projectswithalex/Reaction-Lights-Training-Module/BuildParts/Pictures/Picture3_1.jpg

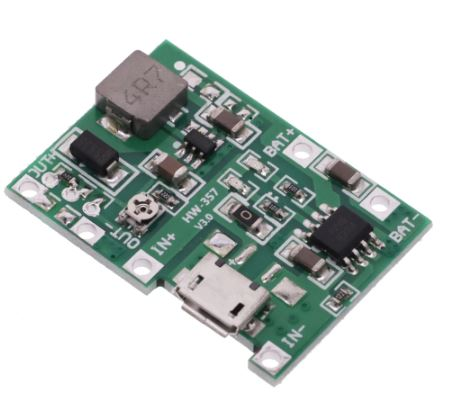
BuildParts/Pictures/Picture3_1.jpg
