projectswithalex/Reaction-Lights-Training-Module/BuildParts/Pictures/Picture3_2.jpg

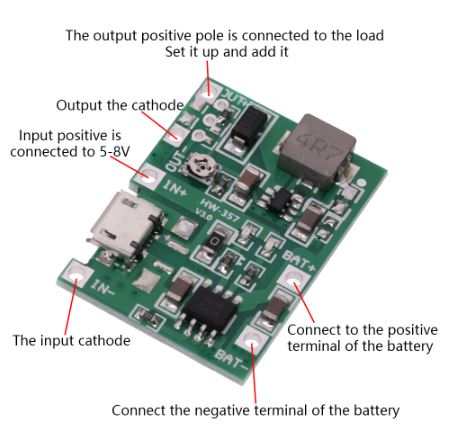
BuildParts/Pictures/Picture3_2.jpg
