projectswithalex/Reaction-Lights-Training-Module/BuildParts/Connection Representation/AgilityLights_Master.png

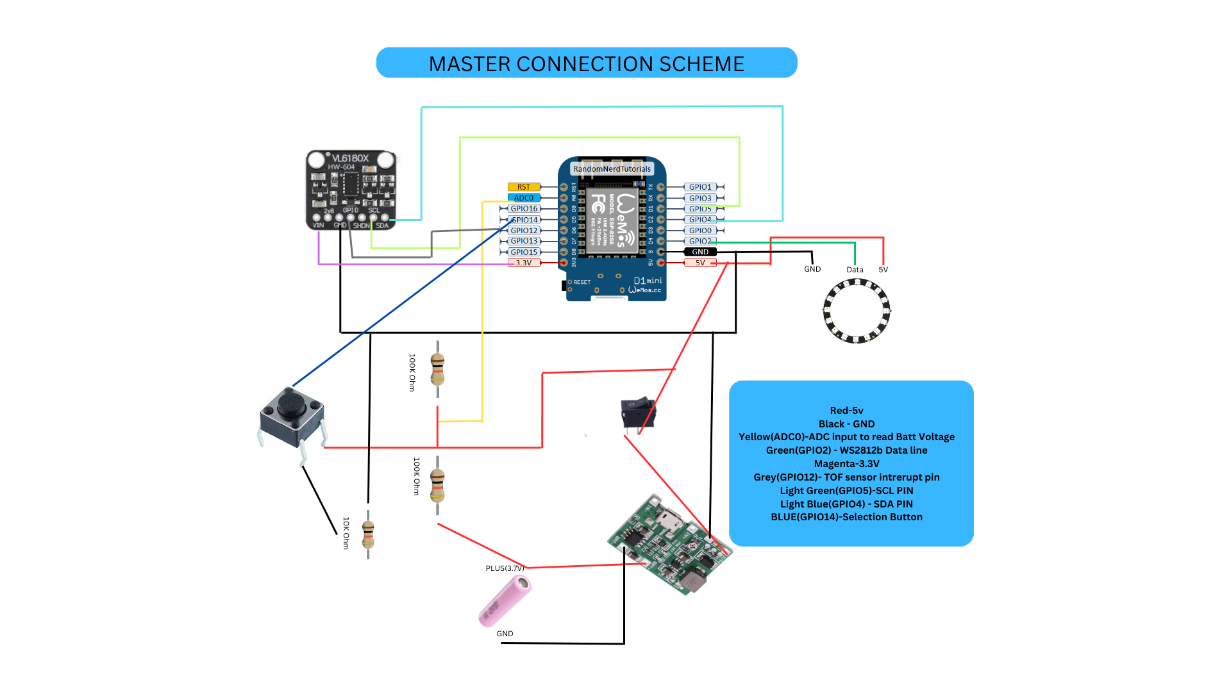
BuildParts/Connection Representation/AgilityLights_Master.png
