projectswithalex/Reaction-Lights-Training-Module/BuildParts/Connection Representation/AgilityLights_NotMaster.png

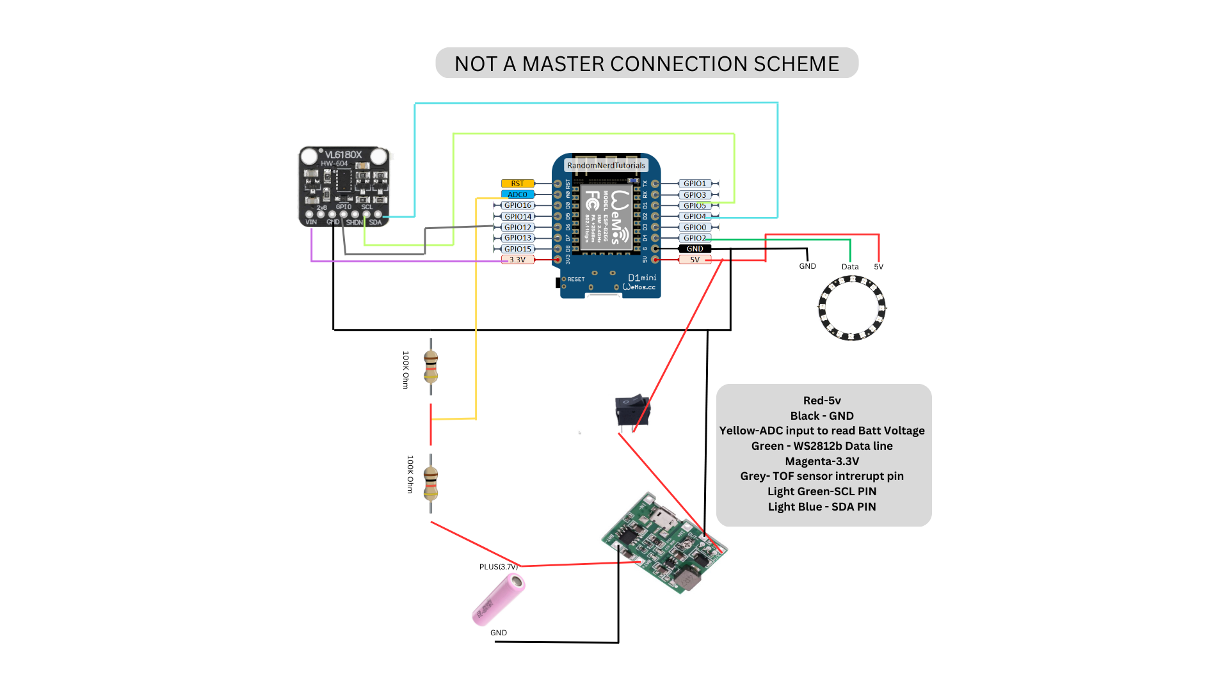
BuildParts/Connection Representation/AgilityLights_NotMaster.png
