projectswithalex/Reaction-Lights-Training-Module/BuildParts/Pictures/Picture1.jpg

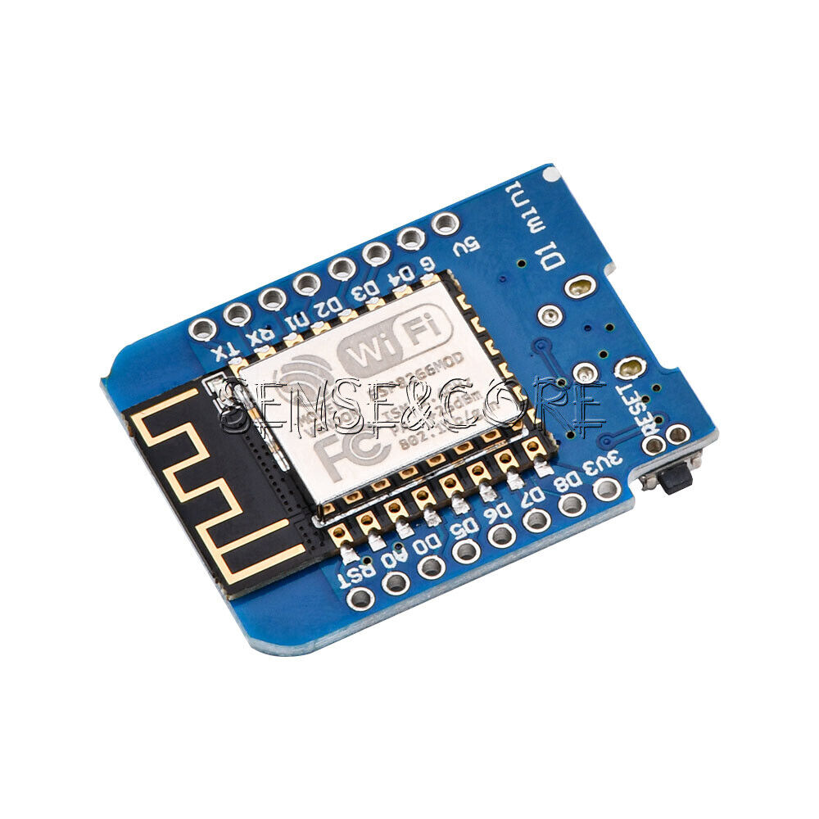
BuildParts/Pictures/Picture1.jpg
