projectswithalex/Reaction-Lights-Training-Module/BuildParts/Pictures/Picture1_2.jpg

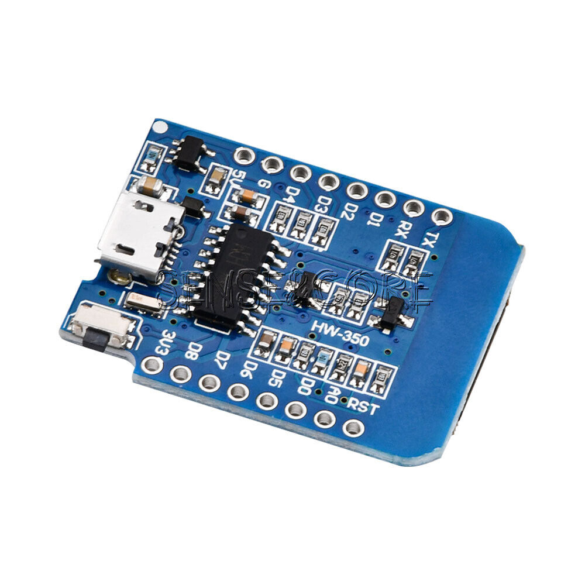
BuildParts/Pictures/Picture1_2.jpg
