projectswithalex/Reaction-Lights-Training-Module/BuildParts/Pictures/Picture2.jpg

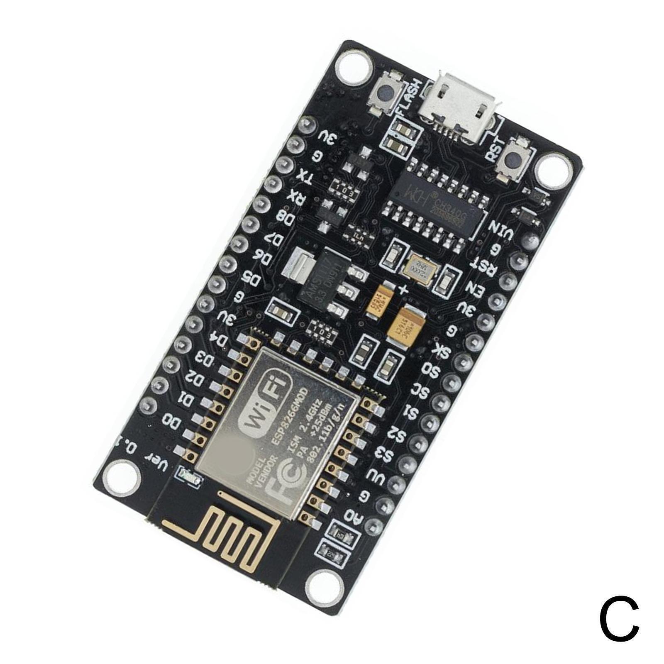
BuildParts/Pictures/Picture2.jpg
