projectswithalex/Reaction-Lights-Training-Module/BuildParts/Pictures/Picture4.jpg

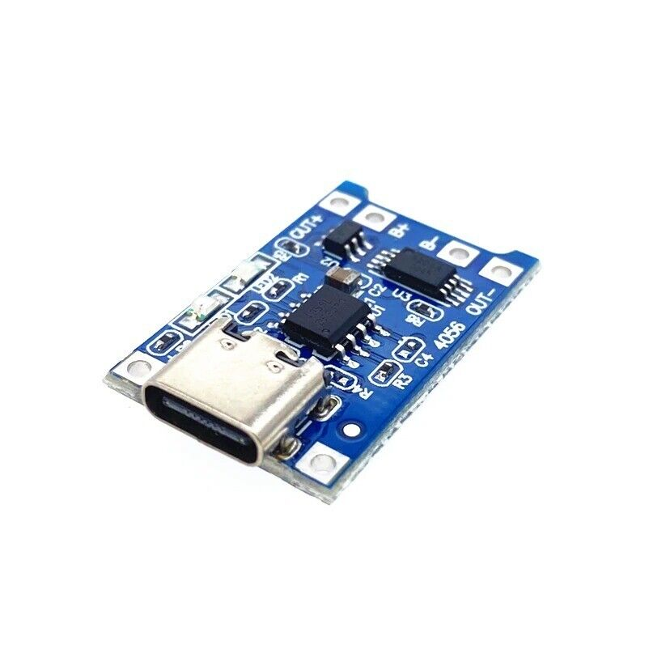
BuildParts/Pictures/Picture4.jpg
