projectswithalex/Reaction-Lights-Training-Module/BuildParts/Pictures/Picture5_1.jpg

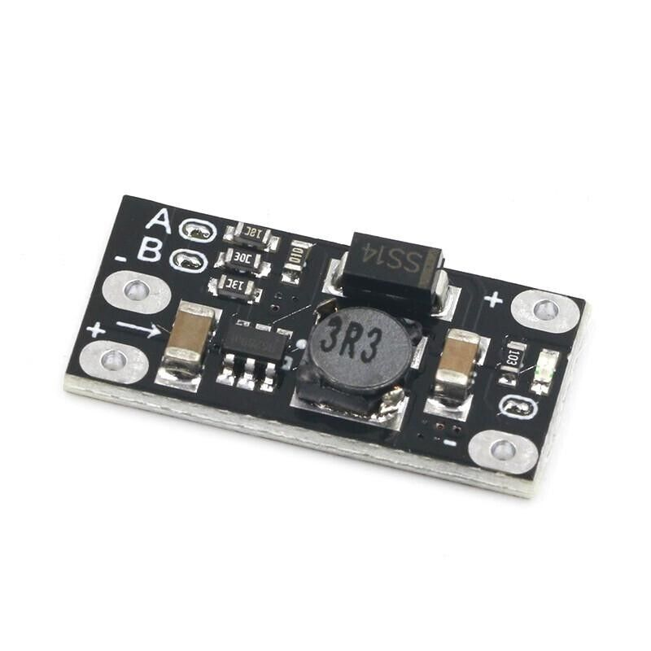
BuildParts/Pictures/Picture5_1.jpg
