projectswithalex/Reaction-Lights-Training-Module/BuildParts/Pictures/Picture5_2.jpg

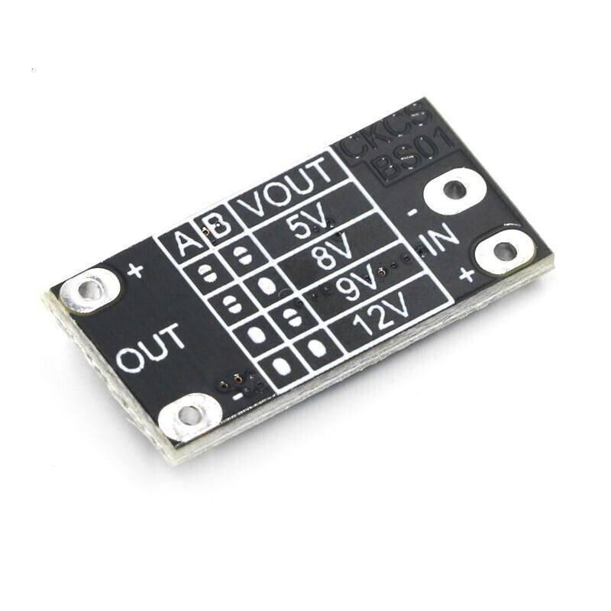
BuildParts/Pictures/Picture5_2.jpg
