projectswithalex/Reaction-Lights-Training-Module/BuildParts/Pictures/Picture6.jpg

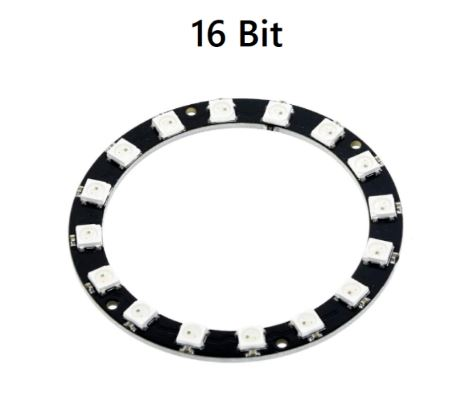
BuildParts/Pictures/Picture6.jpg
