projectswithalex/Reaction-Lights-Training-Module/BuildParts/Pictures/Picture7.jpg

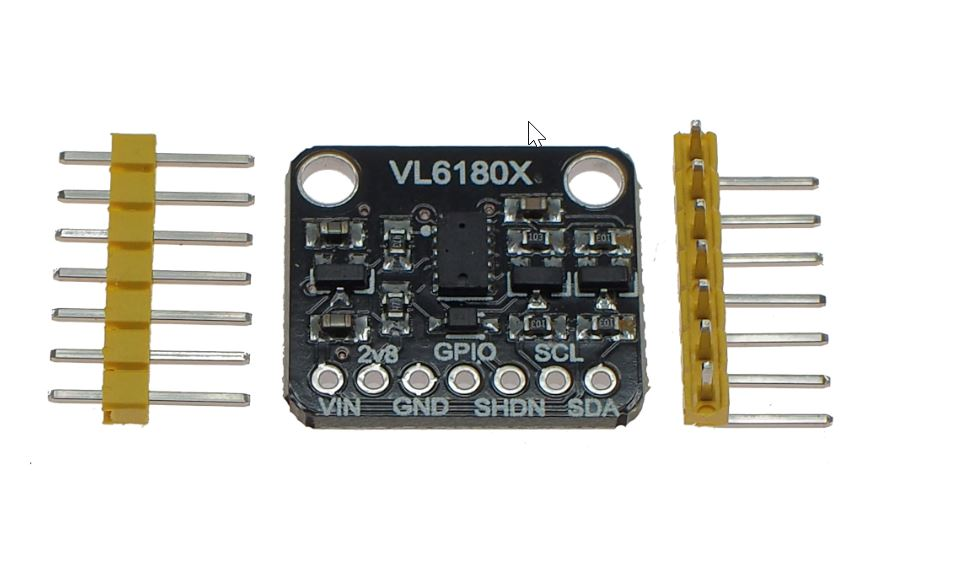
BuildParts/Pictures/Picture7.jpg
