projectswithalex/Reaction-Lights-Training-Module/BuildParts/Pictures/Picture8.jpg

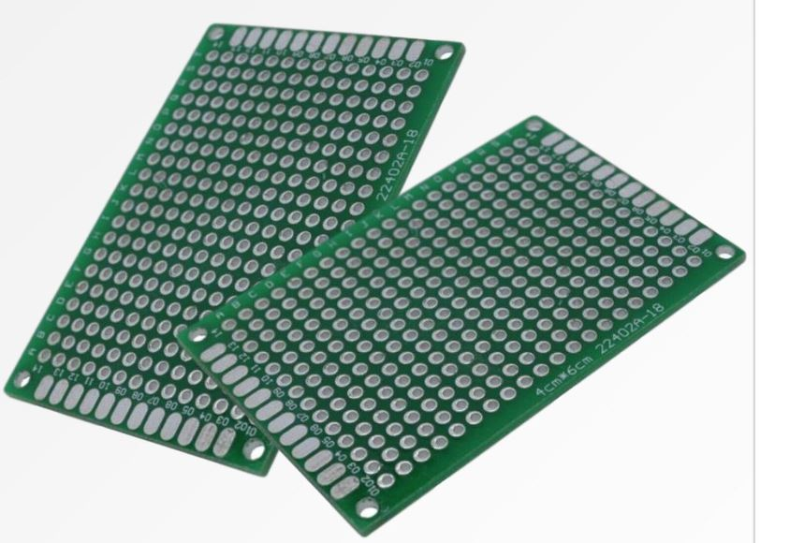
BuildParts/Pictures/Picture8.jpg
