projectswithalex/Reaction-Lights-Training-Module/BuildParts/Pictures/Picture9.jpg

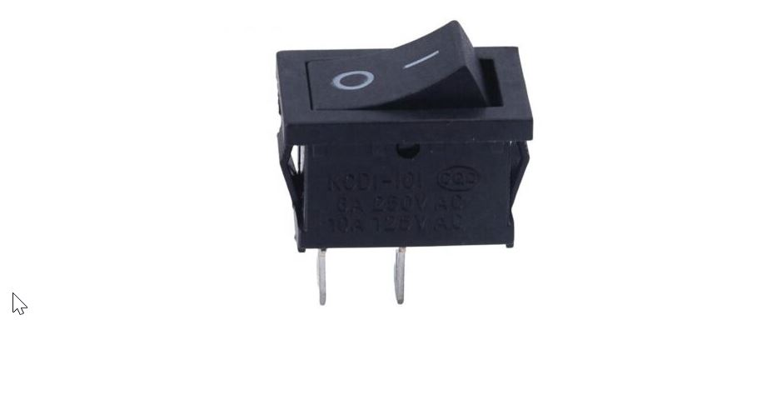
BuildParts/Pictures/Picture9.jpg
