projectswithalex/Reaction-Lights-Training-Module/(threads)

Thread 1 (2023-09-22):

wiring

gemyo1, 2023-09-22:
hello,
thanks for this project.
can you make a document with the wiring on the differents electronics cards please
I want to make my own reaction light but I'm a noob with this cards.

thank you very much

TheprofessionalKhaled, 2023-09-28:
you are right ...the wiring is missing with the appropiate values resisters in the power circuit ..and the proper connection of the sensor

gemyo1, 2023-09-28:
Thanks for the answer, i look forward for the wiring.
;-)

Le jeu. 28 sept. 2023 à 12:15, TheprofessionalKhaled <
***@***.***> a écrit :

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

TheprofessionalKhaled, 2023-09-28:
I already message alex directly on his mail asking him for the wiring ....I
hope he reply to it

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

projectswithalex, 2023-09-28:
Updated "Schematic" (Visual Representation) of the connections for Agility Lights.  (commit #38c155d )

gemyo1, 2023-09-29:
Thanks very much,
It will be very helpful !

Le jeu. 28 sept. 2023, 23:36, projectswithalex ***@***.***> a
écrit :

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

TheprofessionalKhaled, 2023-09-29:
thanks man I appreciate that

Closed 2023-09-28.

Thread 2 (2023-12-26):

Sensor Isn't responding ( high probale cause from code )

TheprofessionalKhaled, 2023-12-26:
hi...how are you ....after several months trying to solve the same issue and asking alot in lots of groups ...I have to open the issue here

First I explian the issue I faced in detail while I record the video of my Project which contian the black piece so please see it as I found I could show the case clearly while operating practical on the project
It is an open source project from alex ...

what happens with my project when I push button the transit to the next configuration settings (which is the job of the sensor ) it didn't transit ...or the sendor didn't take the order
I attach a link to drive I uploaded the video which I record the issue to it so see the video https://drive.google.com/file/d/1cyDlgMK7oVrM3J1ZjFgxhj60-C7nzBI_/view?usp=drive_link

After asking alot  they told me mostly it is from the code, functions responsible for sensoror may be you forgot to determine aspecific settings I should adust (replace here comment)

I also note e 2 things when I connect esp directly to the usb port of the pc first when I apply the test (lightanddistance)the sensor responds and the voltage out from esp8266(from 3.3v and G pins) to sensor is 4.6 to 4.8 v but when I upload the main code of the project and remove the test one the voltage out from esp8266(from 3.3v and G pins) to sensor is 5.6 to 5.8 and the voltage out to ws2818 led rgb ring is from 6.7 to 7 volt even it only accepts 5v written on it So what is that means ?
the second thing like I said i connect the esp to the pc and measure this power i only can measure the volt with avo when i put the avo in the state on alternate voltage V~(avo picture that the arrow of callibration to the green ) and cannot read when avo to points to the red part so what is that mean I thought it reads when its directed to the dc volt ?
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
![Uploading received_893958295349191.jpeg…]
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

gemyo1, 2024-01-03:
Hello,
i made myself this project and i have exactly the same problem.

thx

TheprofessionalKhaled, 2024-01-03:
Like I told you mr alex something is wrong

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

simowilso, 2024-12-28:
I think I'm getting the same/similar problem - did anyone manage to solve this?
In the serial output I can see:
initTOFSensor
initBatteryCheck
battery perc75
almost Ready
Ready
modeSelect:1

I get the modeSelect:1 when pressing the button, but nothing from the TOF sensor.
Pressing the button again gives - training_SelectNrOfECUs:1
and then training_nrOfColors:1

@projectswithalex could you offer any assistance please?

simowilso, 2024-12-29:
Not sure if anyone's still here, but I have got this to work. I've forked my own repo for now as I am a bit of a git amateur and don't really know how to get the changes into a PR. (Not sure if Alex would approve the PR anyway)

TheprofessionalKhaled, 2024-12-29:
What changes do you make that makes the project works …i am really curious?

simowilso, 2024-12-29:
I changed all the classes that the Time of Flight sensor uses from the VL6180X library to VL6180X_WE

See here for changes to ECU1.ino https://github.com/simowilso/Reaction-Lights-Training-Module

TheprofessionalKhaled, 2024-12-29:
So do you mean the problem is from code not electrical issues

Are you sure that the project works fine now ?

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

TheprofessionalKhaled, 2024-12-29:
I cannot believe for more than one year maybe year and half
I spent alots of money
i thought it from electrical or logic
As I studied code and at the end
The error was from using different library than needed

Thanks allah at the end
I appreciate learning alot
And simo for your effort to end that cycle so i can go to another project

Best regards

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

simowilso, 2024-12-29:
I have it working with just the master ECU and one other. I plan to make 5 in total but I think it will work yes. Only code changes except the wiring for the push button on the master - it's not clear from the original drawing how that should be.

Sent from Outlook for Android<https://aka.ms/AAb9ysg>
________________________________
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

TheprofessionalKhaled, 2024-12-29:
you can simplify the pushbutton with 4 legs is same like the one with only
2 legs you connect one leg to D5 and gnd ...the other leg to the voltage
pin ................in the representation he connected to 5 volt but after
asking the pins on the esp is not designed to handle 5 volt
so connect the leg to 3.3 volt pin

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

TheprofessionalKhaled, 2024-12-29:
please if any updates in your project please share it

but how you detect the issue is from the library ...are you a
professional that you get it from experience or is there a clue that says
that happens because of wrong library ?

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

simowilso, 2024-12-29:
There was a test program in the repo that also didn't work- one that read out the distance from the sensor. In the _WE library there' was also a test program and this one did print out the distance values. So I knew the hardware was ok. I updated the test program and got that to work. (This code also updated in my fork). I used to be a C programmer about thousand years ago so yeah a bit of experience.

Sent from Outlook for Android<https://aka.ms/AAb9ysg>
________________________________
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
