projectswithalex/Reaction-Lights-Training-Module/(commit log)

2023-04-01 Code rework.
    Reworked code for easier external user interaction.
    Added Counter Option.
    Fixed Multiple Colors Problem. Also transformed it into an Option.
    Code and Logic Optimization.
    [ECU1.ino, ECU2.ino, ECU3.ino]
2023-04-02 Modified Based Code to be able to run also on ESP32.
2023-07-26 New partner mode algorithm. Rework.
    [ECU1.ino, ECU2.ino, ECU3.ino, ECU4.ino]
2023-07-30 Modified end of training , and restart training and small bugfixes
    [ECU1.ino, ECU2.ino, ECU3.ino, ECU4.ino]
2023-08-03 Bugfix Partner Mode and Manual Agility Lights
    Added Partner Mode skip selected color P1 when selecting color for P2
    [ECU1.ino]
2023-08-07 New Training Type "TimerMode" implementation
2023-08-09 TimerMode bugfixes
2023-08-12 Update and bugfix TimerMode
    [ECU1.ino, ECU2.ino, ECU3.ino, ECU4.ino]
2023-08-12 Update change sensor distance
2023-09-28 Updated "Schematic"
    Visual representation of the connections to build The agility Lights.
